piaskowyk/TilePiano-ArduinoBot/README.md

# TilePiano-ArduinoBot

Arduino bot autonomously playing in android game Title Piano.

more information and description in documentation [here](https://github.com/piaskowyk/TilePiano-ArduinoBot/blob/master/docs/PianoBot_Documentation.pdf):

<p align="center">
  <br>
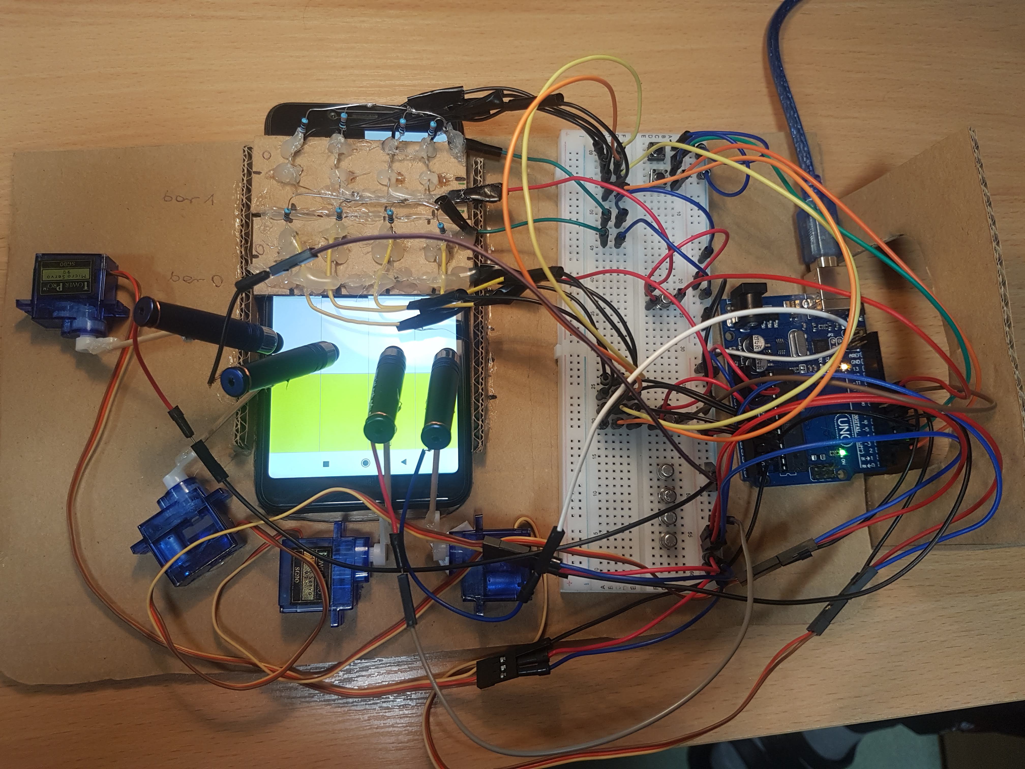
[picture p1: img/s1.jpg]
Title Piano Bot
  
</p>

<p align="center">
  <br>
  Title Piano Bot
</p>

<br />

### Vieo here

video (https://www.youtube.com/watch?v=SxOgB9UIrNY)
