piaskowyk/TilePiano-ArduinoBot/(commit log)

2019-10-15 android application to calibration foto sensors
2019-10-16 interrupt intrval
2019-10-20 calculate velocity
2019-10-20 calibration improve
2019-12-18 servo position aligment
